CyberHooves/0000.0123/report.txt

Info: Processing symbol 'H6:MountingHole:MountingHole_3.2mm_M3_Pad'.
Info: Processing symbol 'C55:Capacitor_SMD:C_1210_3225Metric'.
Info: Processing symbol 'C56:Capacitor_SMD:C_1210_3225Metric'.
Info: Processing symbol 'C57:Capacitor_SMD:C_1210_3225Metric'.
Info: Processing symbol 'H1:MountingHole:MountingHole_3.2mm_M3_Pad'.
Info: Processing symbol 'H2:MountingHole:MountingHole_3.2mm_M3_Pad'.
Info: Processing symbol 'H3:MountingHole:MountingHole_3.2mm_M3_Pad'.
Info: Processing symbol 'H4:MountingHole:MountingHole_3.2mm_M3_Pad'.
Info: Processing symbol 'H5:MountingHole:MountingHole_3.2mm_M3_Pad'.
Info: Processing symbol 'C54:Capacitor_SMD:C_1210_3225Metric'.
Info: Processing symbol 'J1:Connector_JST:JST_PH_B10B-PH-K_1x10_P2.00mm_Vertical'.
Info: Processing symbol 'J2:Connector_JST:JST_PH_B2B-PH-K_1x02_P2.00mm_Vertical'.
Info: Processing symbol 'J3:Connector_JST:JST_PH_B2B-PH-K_1x02_P2.00mm_Vertical'.
Info: Processing symbol 'J4:Connector_JST:JST_PH_B3B-PH-K_1x03_P2.00mm_Vertical'.
Info: Processing symbol 'J5:Connector_JST:JST_PH_B3B-PH-K_1x03_P2.00mm_Vertical'.
Info: Processing symbol 'J6:Connector_Phoenix_MC_HighVoltage:PhoenixContact_MCV_1,5_8-G-5.08_1x08_P5.08mm_Vertical'.
Info: Processing symbol 'L1:Inductor_THT:L_Toroid_Vertical_L22.4mm_W10.2mm_P7.90mm_Vishay_TJ4'.
Info: Processing symbol 'L2:Inductor_THT:L_Toroid_Vertical_L22.4mm_W10.2mm_P7.90mm_Vishay_TJ4'.
Info: Processing symbol 'C53:Capacitor_SMD:C_0805_2012Metric'.
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
Added C44 (footprint 'Capacitor_THT:C_Rect_L10.0mm_W5.0mm_P5.00mm_P7.50mm').
Changed C47 value from C_Rect_L10.0mm_W5.0mm_P5.00mm_P7.50mm to 474.
Connected C45 pin 2 to /CH1-.
Connected C45 pin 2 to /CH1-.
Added C46 (footprint 'Capacitor_THT:C_Rect_L10.0mm_W5.0mm_P5.00mm_P7.50mm').
Connected C47 pin 2 to /CH2-.
Connected C47 pin 2 to /CH2-.
Connected C47 pin 1 to GND.
Connected C47 pin 1 to GND.
Updated C47 properties.
Updated C47 symbol association from  to /c981e8fc-c1c6-4626-895f-d7ba18f4a276.
Connected C45 pin 1 to GND.
Changed REF** reference designator to C47.
Added C47 (footprint 'Capacitor_THT:C_Rect_L10.0mm_W5.0mm_P5.00mm_P7.50mm').
Changed REF** reference designator to C46.
Connected C46 pin 2 to GND.
Connected C46 pin 2 to GND.
Connected C46 pin 1 to /CH2+.
Connected C46 pin 1 to /CH2+.
Updated C46 properties.
Updated C46 symbol association from  to /d306e523-1d9d-4453-af75-b5ba50d5e98f.
Connected C45 pin 1 to GND.
Changed C46 value from C_Rect_L10.0mm_W5.0mm_P5.00mm_P7.50mm to 474.
Changed REF** reference designator to C20.
Changed C20 value from C_Rect_L10.0mm_W5.0mm_P5.00mm_P7.50mm to 474.
Updated C20 symbol association from  to /1f843a81-0c31-44a7-bca4-cbb799aafa26.
Updated C20 properties.
Connected C20 pin 1 to GND.
Connected C20 pin 1 to GND.
Connected C20 pin 2 to /CH2-.
Connected C20 pin 2 to /CH2-.
Updated C45 symbol association from  to /10e9cdca-5bd1-4083-94df-a7015c06eb2a.
Updated C45 properties.
Changed C45 value from C_Rect_L10.0mm_W5.0mm_P5.00mm_P7.50mm to 474.
Warning: No net found for symbol H1 pin 1.
Warning: No net found for symbol H2 pin 1.
Warning: No net found for symbol H3 pin 1.
Warning: No net found for symbol H4 pin 1.
Warning: No net found for symbol H5 pin 1.
Warning: No net found for symbol H6 pin 1.

Info: Total warnings: 0, errors: 0.
