CyberHooves/0000.0123/heat spreader.FCStd

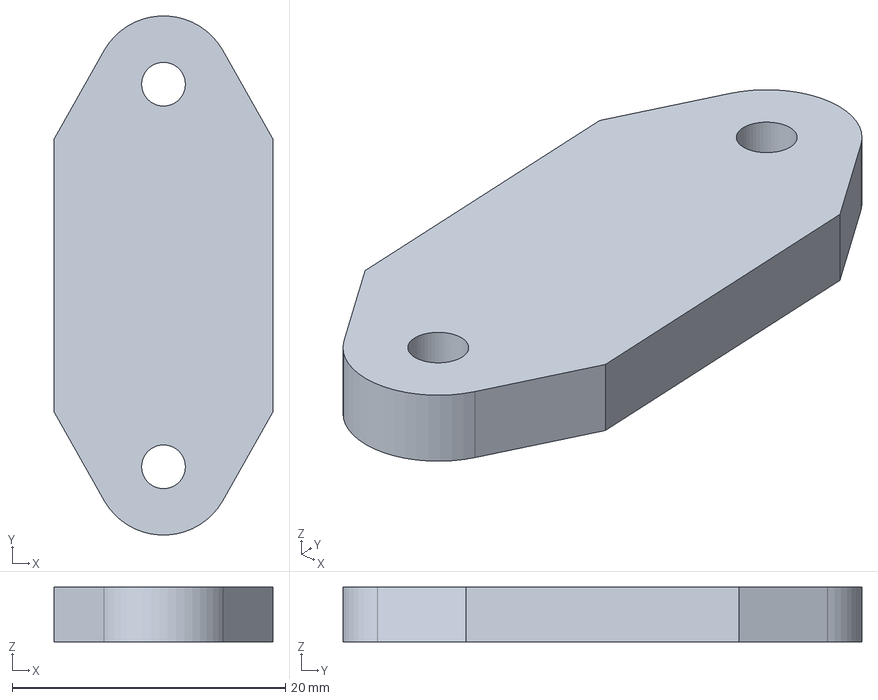
[picture p1: CAD file, 2025-06-01]
heat spreader.FCStd
16.0 x 38.0 x 4.00 mm
