CyberHooves/0000.0123/heatsink.FCStd

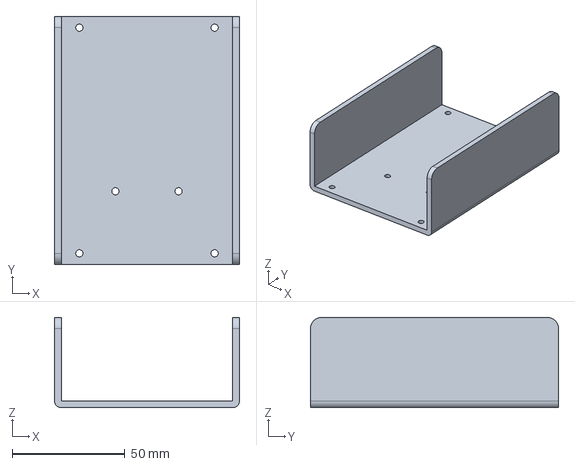
[picture p2: CAD file, 2025-06-01]
heatsink.FCStd
82.0 x 110.0 x 40.0 mm
