CyberHooves/0000.0123/(list of files, cad)

Other CAD files:
heat spreader.dxf
