CyberHooves/0000.0123/0000.0123.kicad_pcb

## KiCad design 0000.0123.kicad_pcb (2025-10-03)

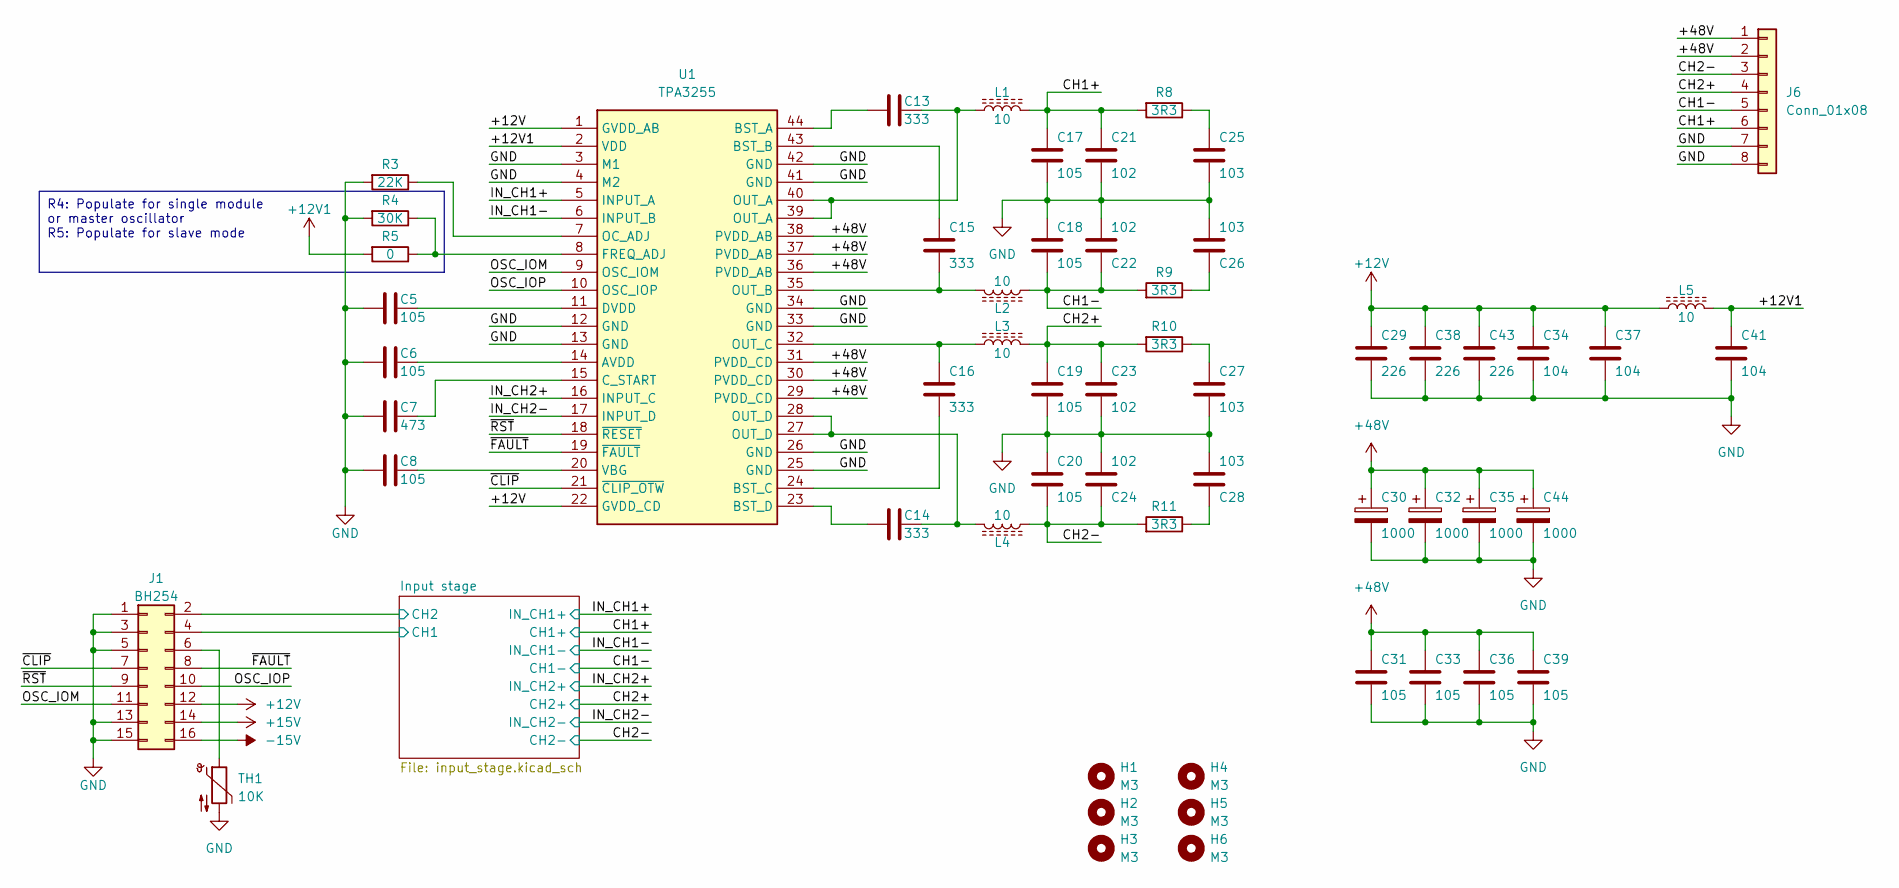
[picture p3: schematic 0000.0123.kicad_sch]

Parts:
C5, C6, C8: 105; C_0805_2012Metric
C7: 473; C_0805_2012Metric
C13, C14, C15, C16: 333; C_0805_2012Metric
C17, C18, C19, C20: 105; C_Rect_L18.0mm_W8.0mm_P15.00mm_FKS3_FKP3
C21, C22, C23, C24: 102; C_0805_2012Metric
C25, C26, C27, C28: 103; C_0805_2012Metric
C29, C38, C43: 226; C_1210_3225Metric
C30, C32, C35, C44: 1000; CP_Radial_D16.0mm_P7.50mm
C31, C33, C36, C39: 105; C_1210_3225Metric
C34, C37, C41: 104; C_0805_2012Metric
H1, H2, H3, H4, H5, H6: M3; MountingHole_3.2mm_M3
J1: BH254; IDC-Header_2x08_P2.54mm_Vertical
J6: Conn_01x08; PhoenixContact_MCV_1,5_8-G-5.08_1x08_P5.08mm_Vertical
L1, L2, L3, L4: 10; L_TOROID_D25_W10_P8_V_1
L5: 10; L_1210_3225Metric
R3: 22K; R_0805_2012Metric
R4: 30K; R_0805_2012Metric
R5: 0; R_0805_2012Metric
R8, R9, R10, R11: 3R3; R_0805_2012Metric
TH1: 10K; R_0805_2012Metric
U1: TPA3255; HTSSOP-44_6.1x14mm_P0.635mm_TopEP4.14x7.01mm

Connections:
+12V: C29.1, C34.1, C37.1, C38.1, C43.1, J1.12, L5.1, U1.1 (GVDD_AB), U1.22 (GVDD_CD)
+12V1: C41.1, L5.2, R5.2, U1.2 (VDD)
+15V: J1.14; also elsewhere on the board
+48V: C30.1, C31.1, C32.1, C33.1, C35.1, C36.1, C39.1, C44.1, J6.1, J6.2, U1.29 (PVDD_CD), U1.30 (PVDD_CD), U1.31 (PVDD_CD), U1.36 (PVDD_AB), U1.37 (PVDD_AB), U1.38 (PVDD_AB)
-15V: J1.16; also elsewhere on the board
/CH1+: C17.1, C21.1, J6.6, L1.2, R8.2; also elsewhere on the board
/CH1-: C18.2, C22.1, J6.5, L2.2, R9.2; also elsewhere on the board
/CH2+: C19.1, C23.1, J6.4, L3.2, R10.2; also elsewhere on the board
/CH2-: C20.2, C24.1, J6.3, L4.2, R11.2; also elsewhere on the board
/IN_CH1+: U1.5 (INPUT_A); also elsewhere on the board
/IN_CH1-: U1.6 (INPUT_B); also elsewhere on the board
/IN_CH2+: U1.16 (INPUT_C); also elsewhere on the board
/IN_CH2-: U1.17 (INPUT_D); also elsewhere on the board
/Input stage/CH1: J1.4; also elsewhere on the board
/Input stage/CH2: J1.2; also elsewhere on the board
/OSC_IOM: J1.11, U1.9 (OSC_IOM)
/OSC_IOP: J1.10, U1.10 (OSC_IOP)
/~CLIP: J1.7, U1.21 (~CLIP_OTW)
/~FAULT: J1.8, U1.19 (~FAULT)
/~RST: J1.9, U1.18 (~RESET)
GND: C5.1, C6.1, C7.1, C8.1, C17.2, C18.1, C19.2, C20.1, C21.2, C22.2, C23.2, C24.2, C25.2, C26.2, C27.2, C28.2, C29.2, C30.2, C31.2, C32.2, C33.2, C34.2, C35.2, C36.2, C37.2, C38.2, C39.2, C41.2, C43.2, C44.2, J1.1, J1.3, J1.5, J1.13, J1.15, J6.7, J6.8, R3.2, R4.2, TH1.2, U1.3 (M1), U1.4 (M2), U1.12 (GND), U1.13 (GND), U1.25 (GND), U1.26 (GND), U1.33 (GND), U1.34 (GND), U1.41 (GND), U1.42 (GND); also elsewhere on the board
unnamed: C13.2, L1.1, U1.39 (OUT_A), U1.40 (OUT_A)
unnamed: C14.2, L4.1, U1.27 (OUT_D), U1.28 (OUT_D)
unnamed: C25.1, R8.1
unnamed: C26.1, R9.1
unnamed: C27.1, R10.1
unnamed: C28.1, R11.1
unnamed: J1.6, TH1.1
unnamed: C6.2, U1.14 (AVDD)
unnamed: C13.1, U1.44 (BST_A)
unnamed: C15.1, U1.43 (BST_B)
unnamed: C16.2, U1.24 (BST_C)
unnamed: C14.1, U1.23 (BST_D)
unnamed: C7.2, U1.15 (C_START)
unnamed: C5.2, U1.11 (DVDD)
unnamed: R4.1, R5.1, U1.8 (FREQ_ADJ)
unnamed: R3.1, U1.7 (OC_ADJ)
unnamed: C15.2, L2.1, U1.35 (OUT_B)
unnamed: C16.1, L3.1, U1.32 (OUT_C)
unnamed: C8.2, U1.20 (VBG)

Notes on the sheet:
R4: Populate for single module or master oscillator R5: Populate for slave mode

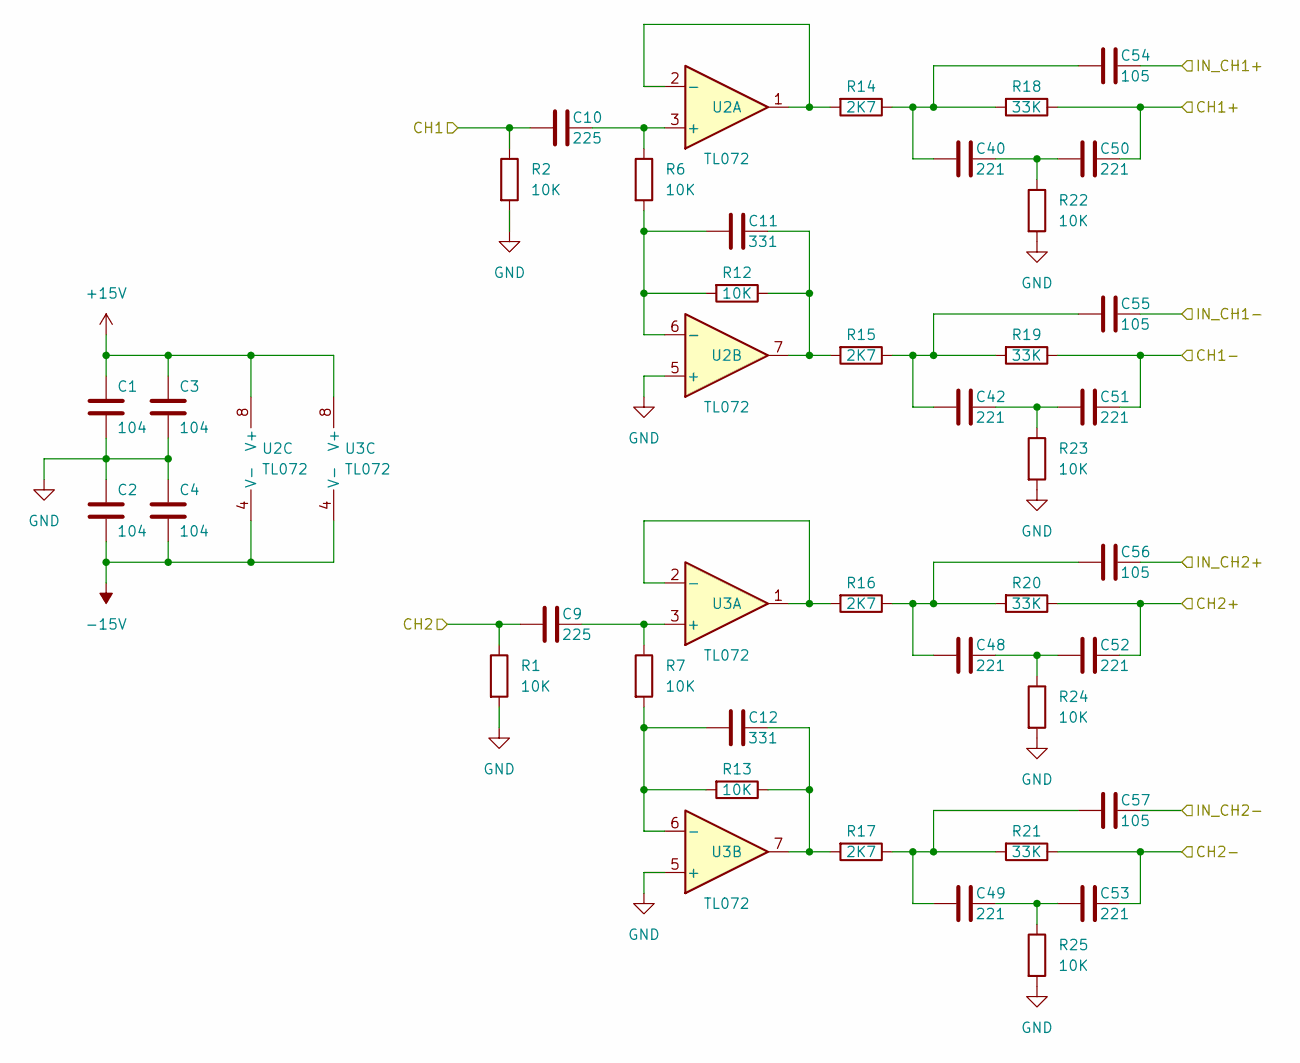
[picture p4: schematic input_stage.kicad_sch]

Parts:
C1, C2, C3, C4: 104; C_0805_2012Metric
C9, C10: 225; C_1210_3225Metric
C11, C12: 331; C_0805_2012Metric
C40, C42, C48, C49, C50, C51, C52, C53: 221; C_0805_2012Metric
C54, C55, C56, C57: 105; C_0805_2012Metric
R1, R2, R6, R7, R12, R13, R22, R23, R24, R25: 10K; R_0805_2012Metric
R14, R15, R16, R17: 2K7; R_0805_2012Metric
R18, R19, R20, R21: 33K; R_0805_2012Metric
U2, U3: TL072; SOIC-8_3.9x4.9mm_P1.27mm

Connections:
+15V: C1.1, C3.1, U2.8 (V+), U3.8 (V+); also elsewhere on the board
-15V: C2.2, C4.2, U2.4 (V-), U3.4 (V-); also elsewhere on the board
/CH1+: C50.2, R18.1; also elsewhere on the board
/CH1-: C51.2, R19.1; also elsewhere on the board
/CH2+: C52.2, R20.1; also elsewhere on the board
/CH2-: C53.2, R21.1; also elsewhere on the board
/IN_CH1+: C54.2; also elsewhere on the board
/IN_CH1-: C55.2; also elsewhere on the board
/IN_CH2+: C56.2; also elsewhere on the board
/IN_CH2-: C57.2; also elsewhere on the board
/Input stage/CH1: C10.1, R2.1; also elsewhere on the board
/Input stage/CH2: C9.1, R1.1; also elsewhere on the board
GND: C1.2, C2.1, C3.2, C4.1, R1.2, R2.2, R22.2, R23.2, R24.2, R25.2, U2.5 (+), U3.5 (+); also elsewhere on the board
unnamed: C11.2, R12.1, R15.2, U2.7
unnamed: C12.2, R13.1, R17.2, U3.7
unnamed: C40.1, C54.1, R14.1, R18.2
unnamed: C40.2, C50.1, R22.1
unnamed: C42.1, C55.1, R15.1, R19.2
unnamed: C42.2, C51.1, R23.1
unnamed: C48.1, C56.1, R16.1, R20.2
unnamed: C48.2, C52.1, R24.1
unnamed: C49.1, C57.1, R17.1, R21.2
unnamed: C49.2, C53.1, R25.1
unnamed: C10.2, R6.1, U2.3 (+)
unnamed: R14.2, U2.1, U2.2 (-)
unnamed: C11.1, R6.2, R12.2, U2.6 (-)
unnamed: C9.2, R7.1, U3.3 (+)
unnamed: R16.2, U3.1, U3.2 (-)
unnamed: C12.1, R7.2, R13.2, U3.6 (-)

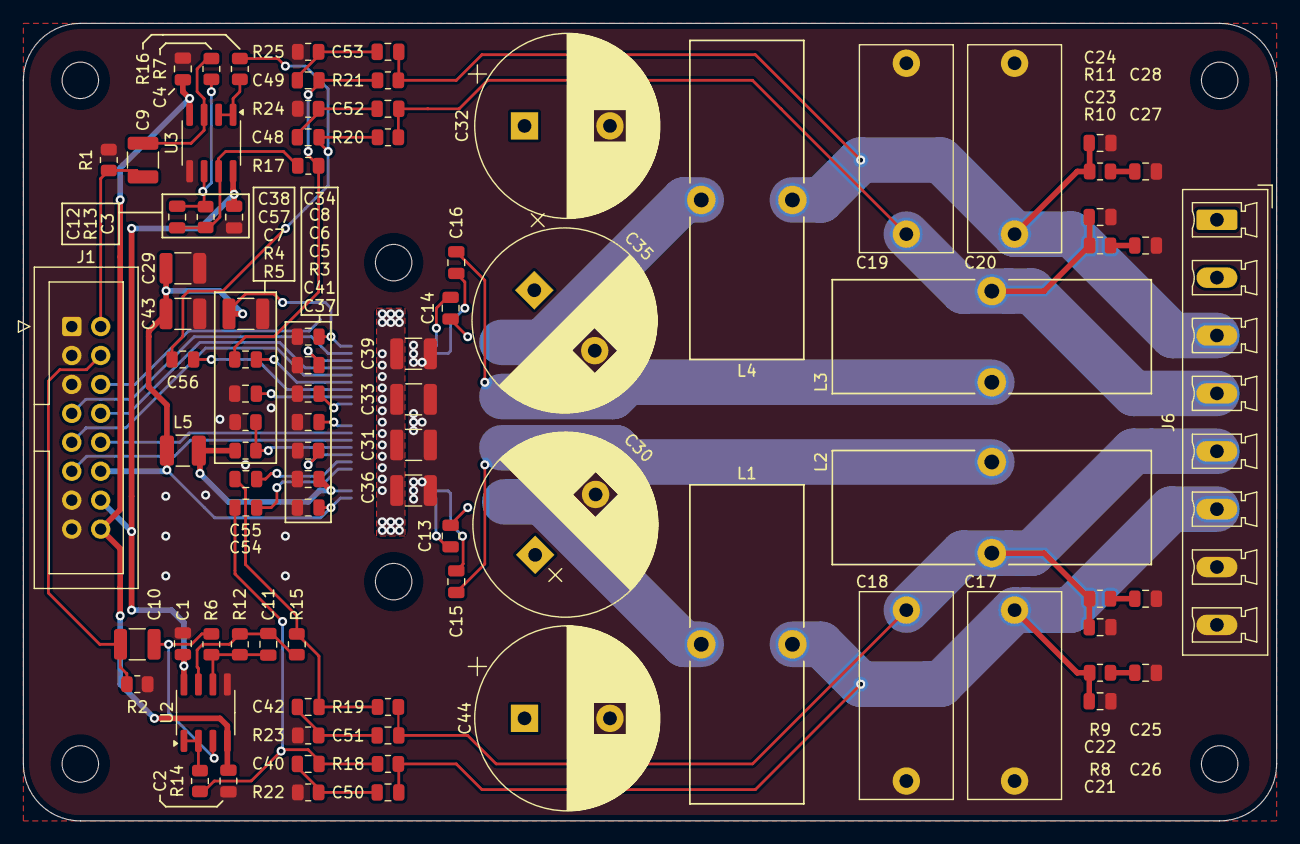
[picture p5: board 0000.0123.kicad_pcb from above]

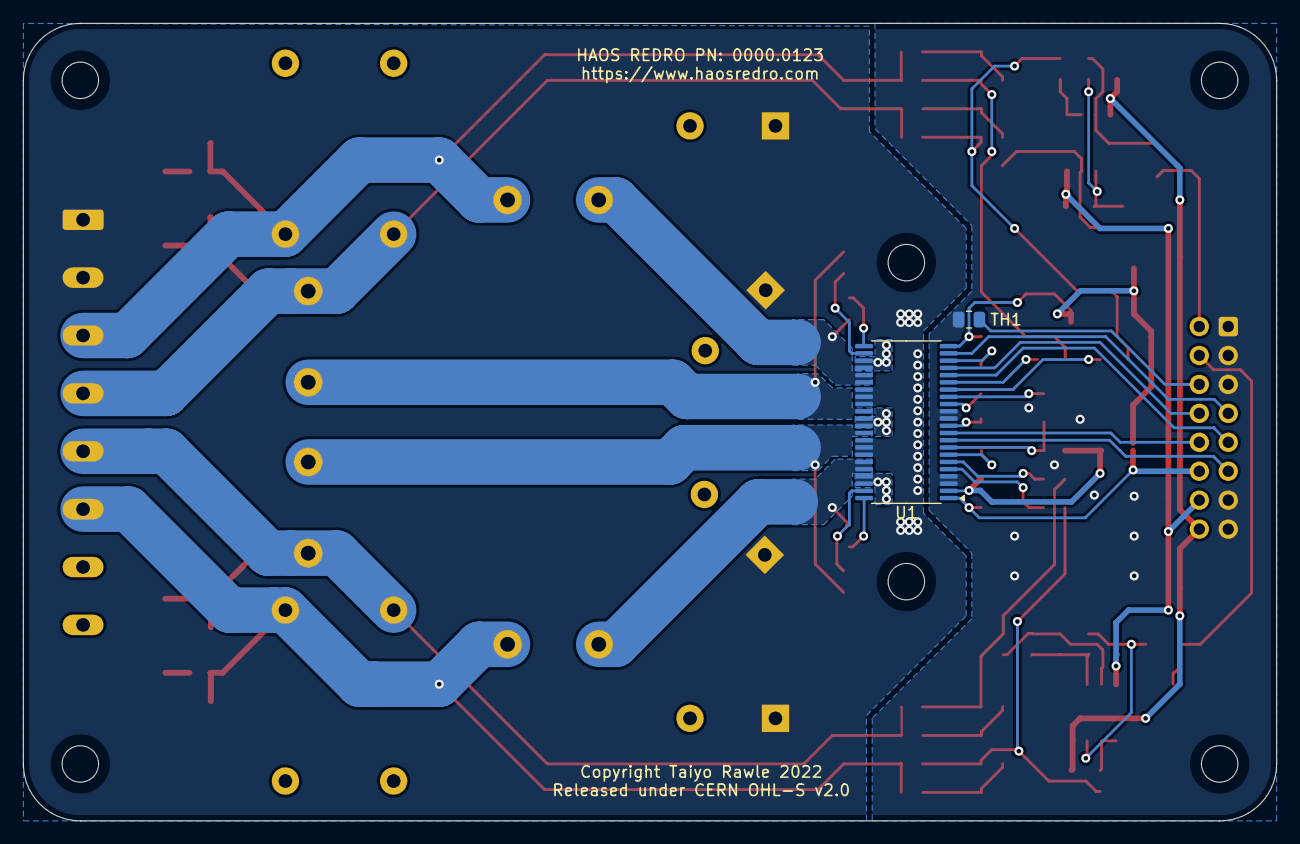
[picture p6: board 0000.0123.kicad_pcb from below]

Board: 2 copper layers, 110.0 x 70.0 mm, 96 parts (2 on the bottom side), 56 nets.
