CyberHooves/0000.0123/(commit log)

2025-06-06 Updated PCB layout.
    [0000.0123.kicad_pcb]
2025-10-03 Fixed minor error - R5 is now connected to +12V1 instead of +12V.
    [0000.0123.kicad_pcb, 0000.0123.kicad_sch]
2025-10-03 Fixed some whoopsies.
    [0000.0123.kicad_pcb, input_stage.kicad_sch]
