CyberHooves/0000.0123/(notices)

Notices in the files:
0000.0123.kicad_pcb:
Copyright Taiyo Rawle 2022
Released under CERN OHL-S v2.0
